sujan-coder/Automatic-Fish-Feeder/Automatic Fish Feeder with gear solution/README.txt

Automatic Fish Feeder with gear solution. by Steve5092 on Thingiverse: https://www.thingiverse.com/thing:2939568

Summary:
Automatic fish feederUpdated version.Improve the drill shaft mechanism and reduce friction.Parts List:Nuts &amp; Bolts M4 X 20mm Screws X 2N20 DC Gear Motor Miniature High Torque Electric Gear Box Motor X 1Arduino nano X 1Oneway relay X 1
