sujan-coder/Automatic-Fish-Feeder/Automatic Fish Feeder with gear solution/images/9d3d602a2836ed18df4abee3c9418d6d.png

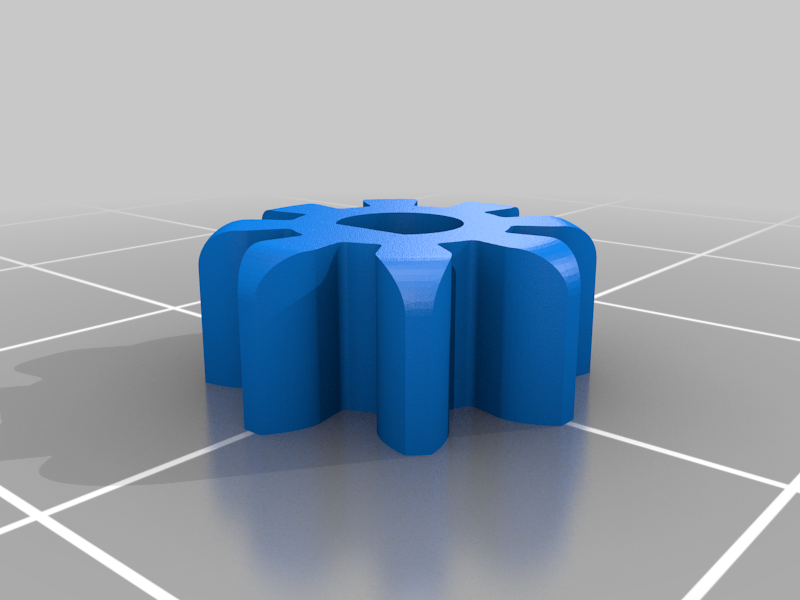
Automatic Fish Feeder with gear solution/images/9d3d602a2836ed18df4abee3c9418d6d.png
