sujan-coder/Automatic-Fish-Feeder/Automatic Fish Feeder with gear solution/images/054ba2459d051ea91113a32c5700b777.png

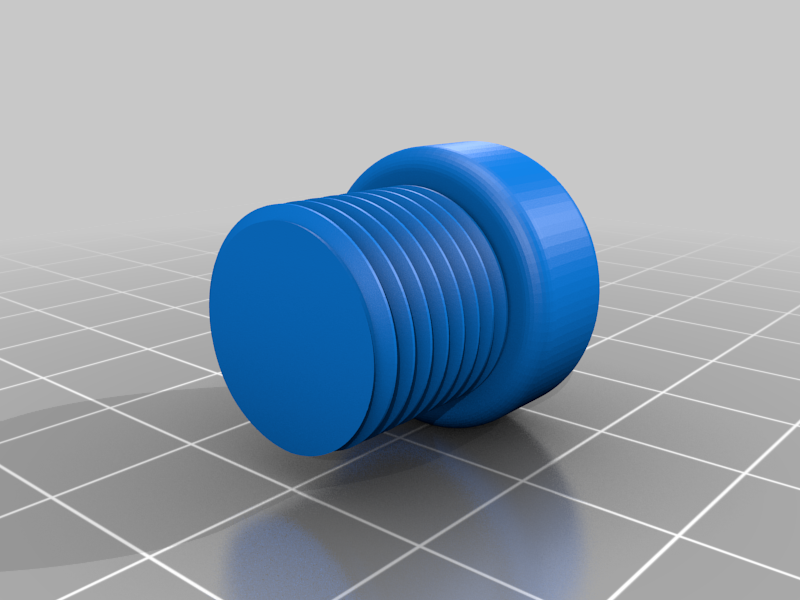
Automatic Fish Feeder with gear solution/images/054ba2459d051ea91113a32c5700b777.png
