sujan-coder/Automatic-Fish-Feeder/Automatic Fish Feeder with gear solution/images/65e4e3066ea227c0265036ff6c3ee77d.png

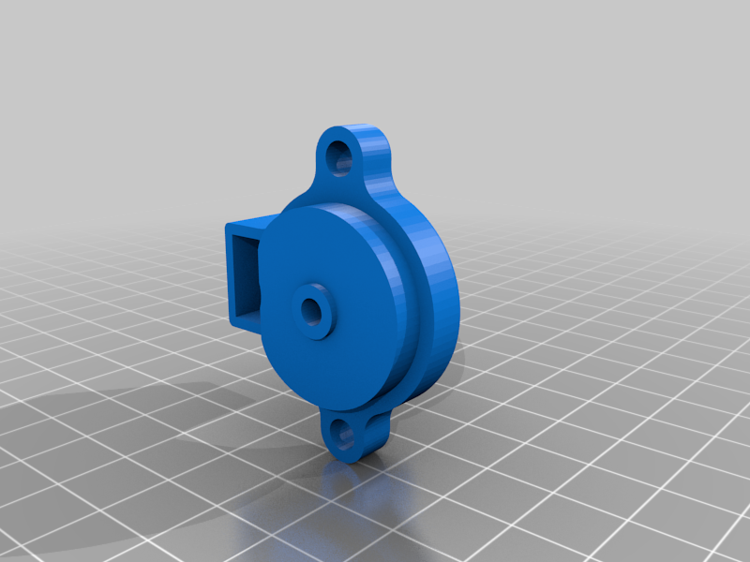
Automatic Fish Feeder with gear solution/images/65e4e3066ea227c0265036ff6c3ee77d.png
