sujan-coder/Automatic-Fish-Feeder/Automatic Fish Feeder with gear solution/images/_2018-06-03_12.44.57.png

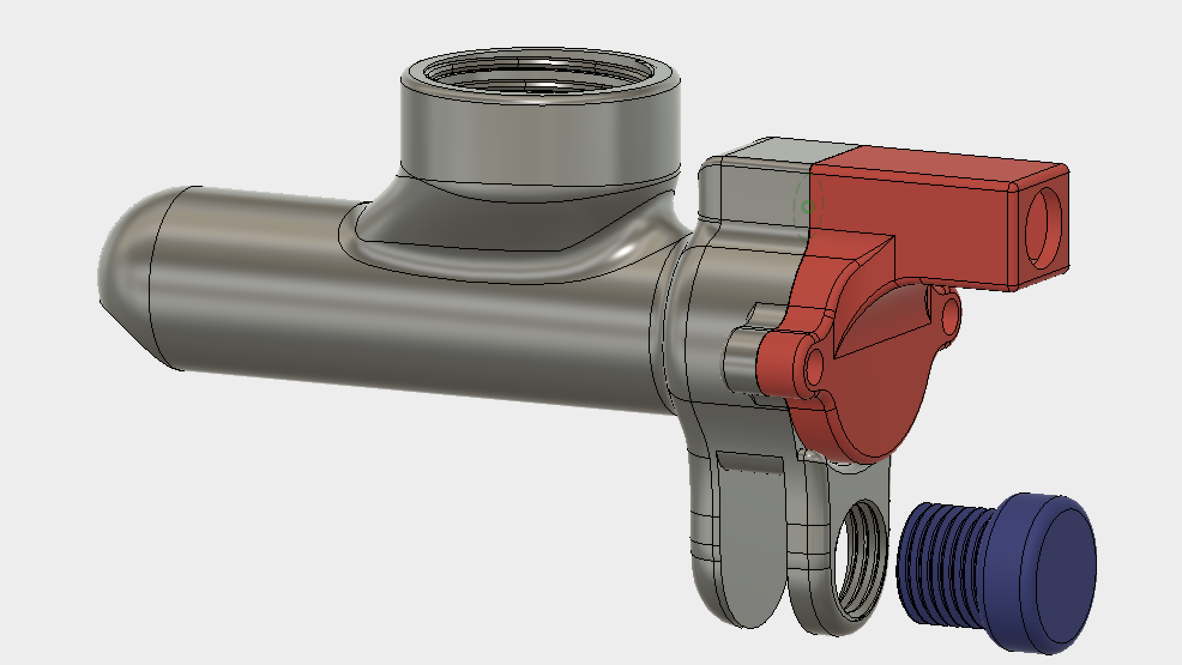
Automatic Fish Feeder with gear solution/images/_2018-06-03_12.44.57.png
