sujan-coder/Automatic-Fish-Feeder/Automatic Fish Feeder with gear solution/images/a9b66d680f23909fe4b3376bffe5c0f1.png

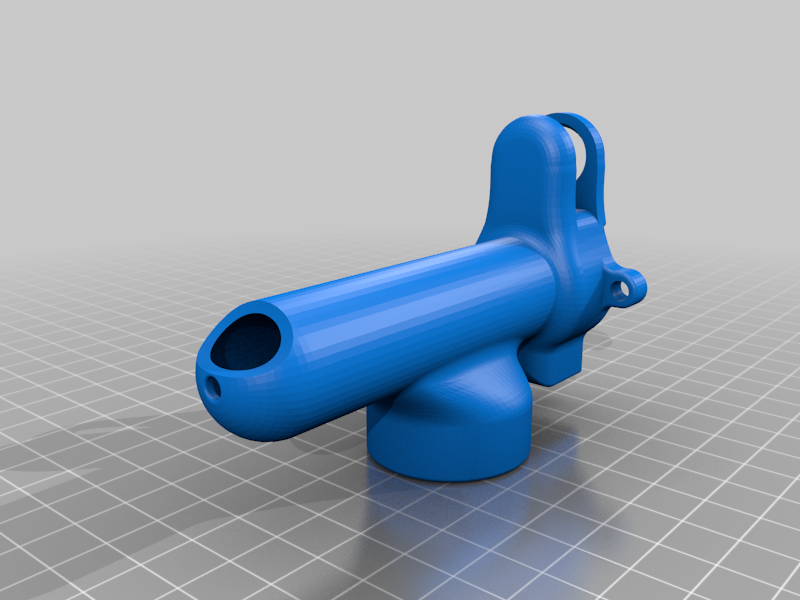
Automatic Fish Feeder with gear solution/images/a9b66d680f23909fe4b3376bffe5c0f1.png
