sujan-coder/Automatic-Fish-Feeder/Automatic Fish Feeder with gear solution/images/IMG_1121.JPG

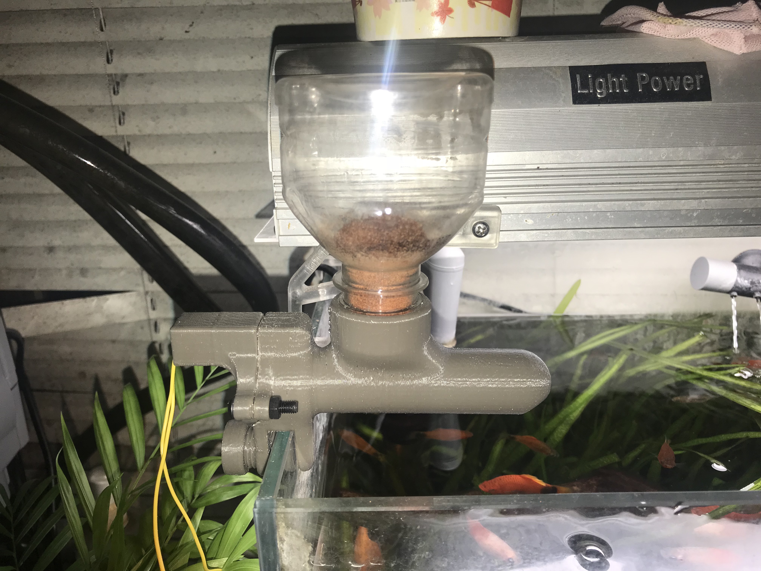
Automatic Fish Feeder with gear solution/images/IMG_1121.JPG
