sujan-coder/Automatic-Fish-Feeder/Automatic Fish Feeder with gear solution/files/fish_feeder_drill.stl

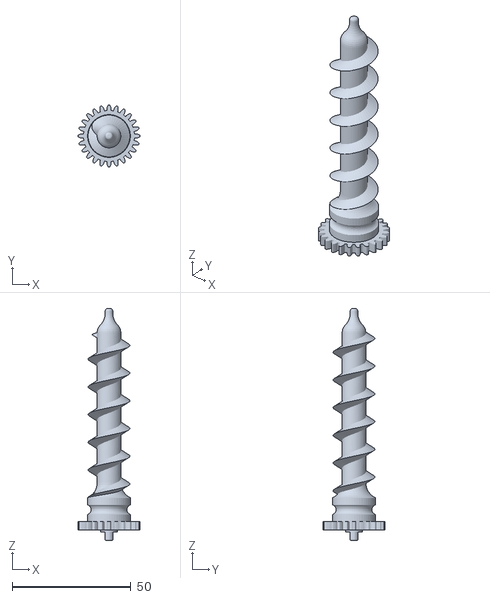
[picture p12: CAD file, 2026-11-05]
Automatic Fish Feeder with gear solution/files/fish_feeder_drill.stl
26.0 x 26.0 x 97.7
