sujan-coder/Automatic-Fish-Feeder/Automatic Fish Feeder with gear solution/files/fish_feeder_body.stl

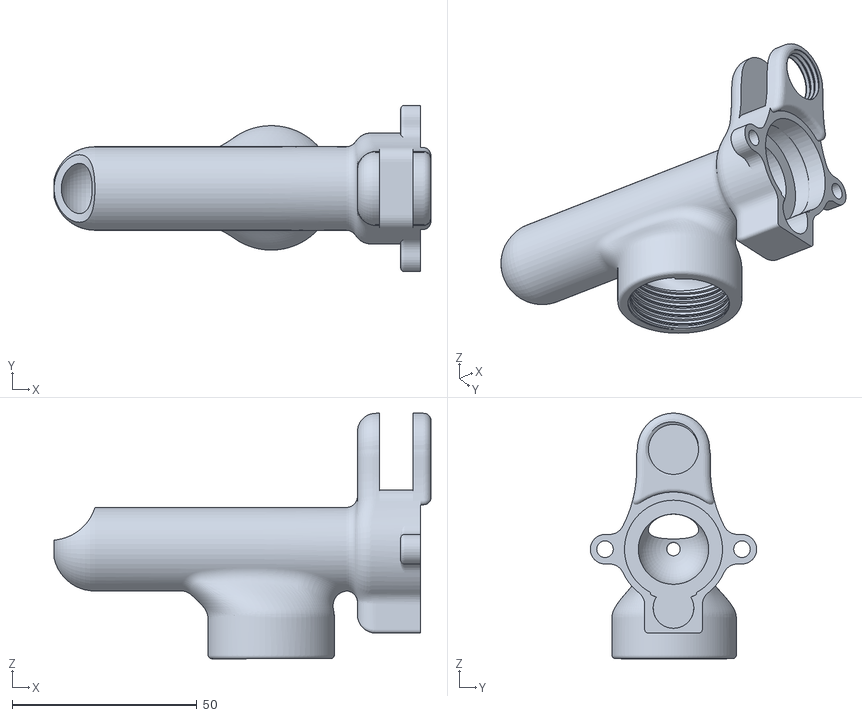
[picture p13: CAD file, 2026-11-05]
Automatic Fish Feeder with gear solution/files/fish_feeder_body.stl
102.0 x 45.0 x 66.4
