sujan-coder/Automatic-Fish-Feeder/Automatic Fish Feeder with gear solution/files/fish_feeder_gear_chamber_1.stl

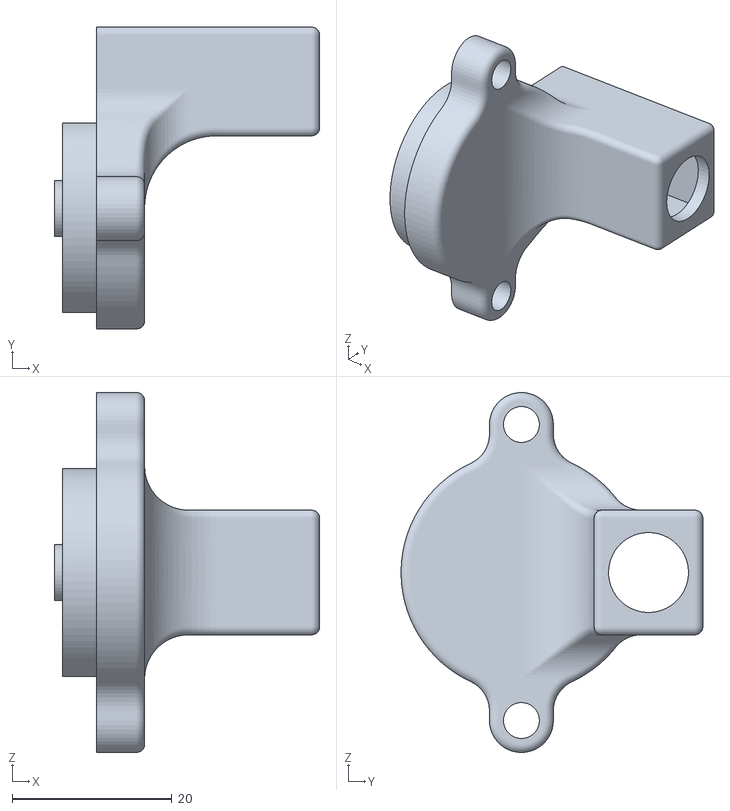
[picture p14: CAD file, 2026-11-05]
Automatic Fish Feeder with gear solution/files/fish_feeder_gear_chamber_1.stl
33.2 x 37.7 x 45.0
