sujan-coder/Automatic-Fish-Feeder/Automatic Fish Feeder with gear solution/files/fish_feeder_small_gear.stl

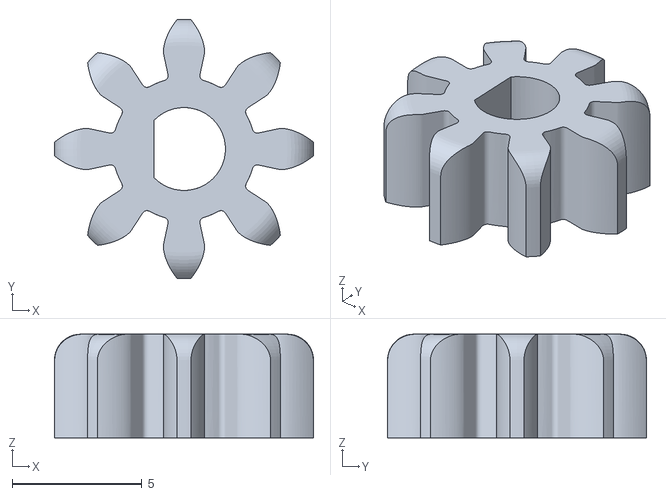
[picture p15: CAD file, 2026-11-05]
Automatic Fish Feeder with gear solution/files/fish_feeder_small_gear.stl
10.00 x 10.00 x 4.00
