sujan-coder/Automatic-Fish-Feeder/Automatic Fish Feeder with gear solution/files/fish_feeder__screw.stl

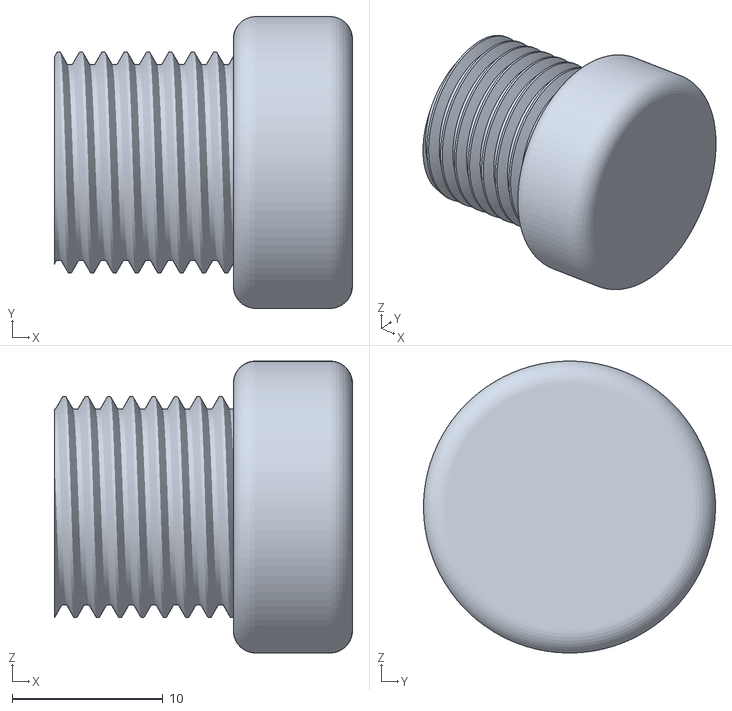
[picture p16: CAD file, 2026-11-05]
Automatic Fish Feeder with gear solution/files/fish_feeder__screw.stl
19.8 x 19.4 x 19.4
